eduardossampaio/strangerthingsboard/media/resources/background.jpg

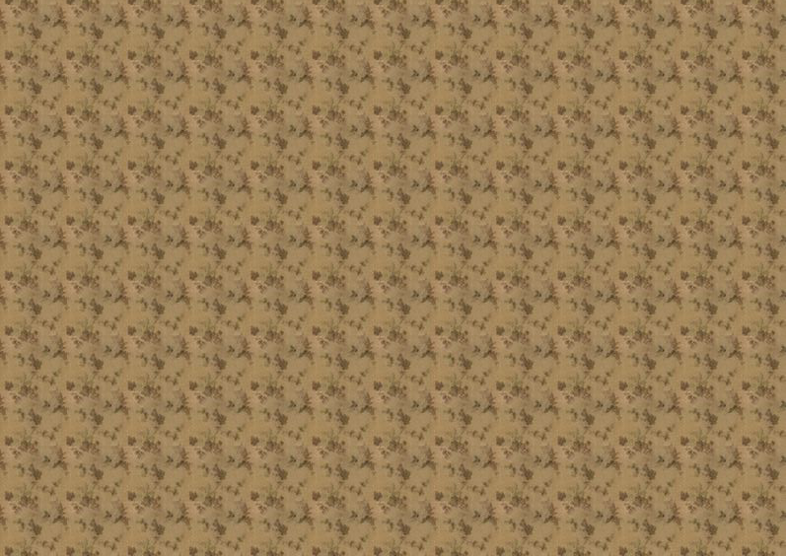
media/resources/background.jpg
