eduardossampaio/strangerthingsboard/media/resources/il_570xN.1339443868_1fz2.jpg

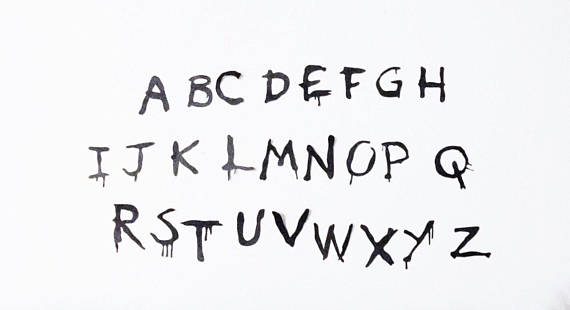
media/resources/il_570xN.1339443868_1fz2.jpg
