eduardossampaio/strangerthingsboard/media/resources/letters/font.png

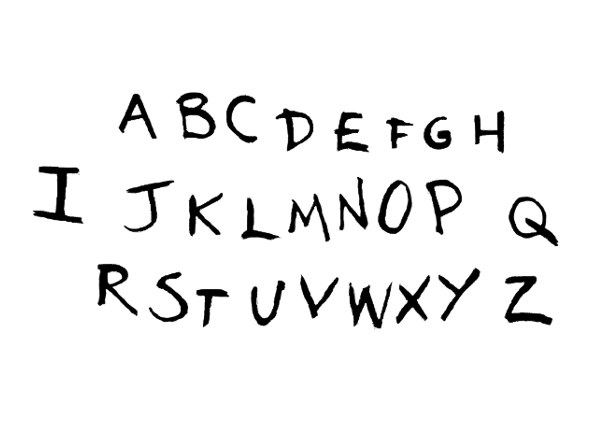
media/resources/letters/font.png
