eduardossampaio/strangerthingsboard/media/resources/photo-frame-background.png

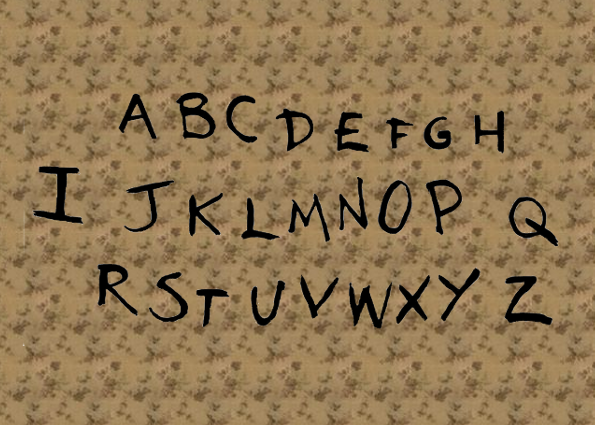
media/resources/photo-frame-background.png
