eduardossampaio/strangerthingsboard/media/resources/s-l1600.jpg

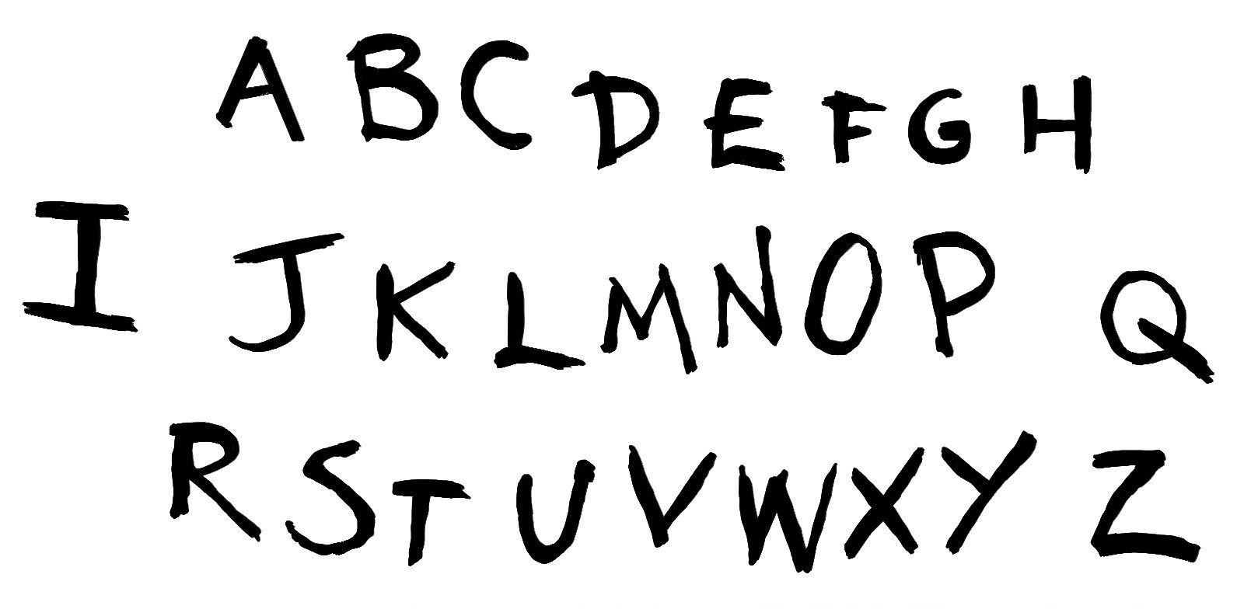
media/resources/s-l1600.jpg
