eduardossampaio/strangerthingsboard/media/resources/StrangerThingsClose_5c9a3019-cdf3-427e-8b0a-3b6e0e7c50b7_1024x1024.png

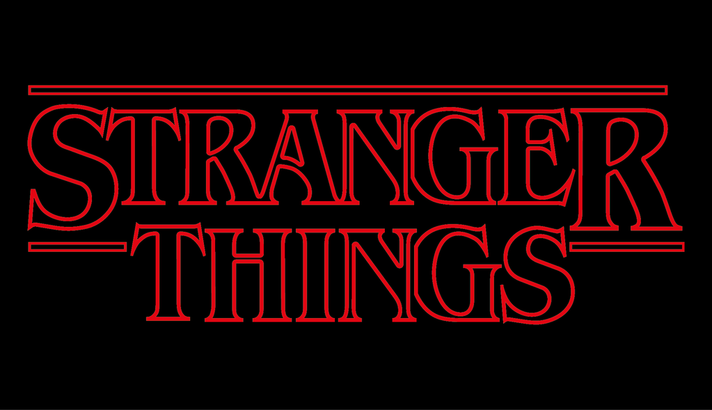
media/resources/StrangerThingsClose_5c9a3019-cdf3-427e-8b0a-3b6e0e7c50b7_1024x1024.png
