eduardossampaio/strangerthingsboard/(commit log)

2018-05-29 blinking leds
2018-06-02 - uploading media and resources - uploading arduino code - adding bluetooth connection
2018-06-02 changing name of arduino project
